SPidrmAN99/SpiderHex/README.md

<h1 align="center">SPIDER-HEX</h1>

<p align="center">
  <strong>A six-legged robot, built from gears, servos, and a lot of iteration.</strong><br>
  Mechanical design · ESP32 MicroPython · Bluetooth control
</p>

<p align="center">
  
  
  
  
</p>

<p align="center">
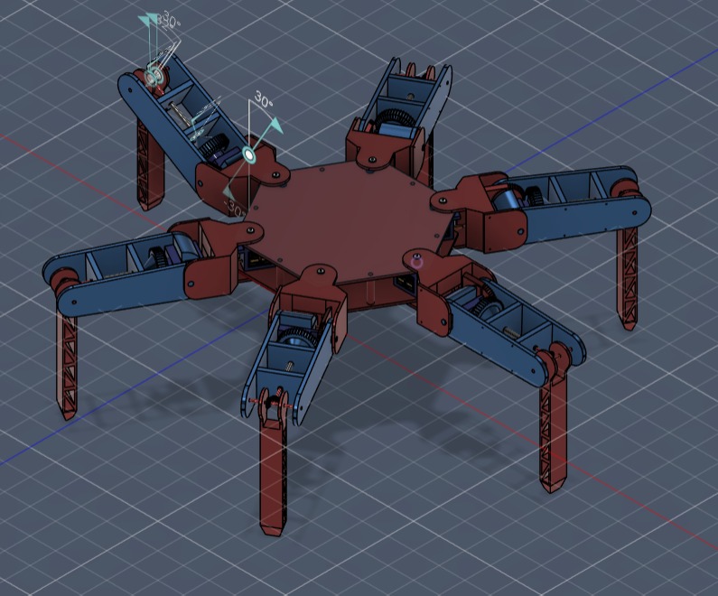
[picture p1: docs/images/final-design-cad.jpg]
CAD concept for the final Spider-Hex design, showing six geared legs around the central body
  
</p>

<p align="center">
  <strong>Final design direction — six geared legs around a compact central body.</strong><br><sub><a href="docs/images/final-design-fusion-screenshot.png">Open the original Fusion screenshot</a></sub>
</p>

---

## The project

Spider-Hex is a six-legged hexapod platform exploring custom geared leg mechanisms and wireless movement control. The repository brings together ESP32 firmware, BLE clients, control notes, CAD renders, build photos, and progress videos.

| At a glance |  |
|:--|:--|
| **Locomotion** | Six legs with hip and knee servo channels |
| **Controller** | ESP32 running MicroPython |
| **Wireless link** | Bluetooth Low Energy using a Nordic UART-style service |
| **Servo driver** | PCA9685 over I²C |
| **Development status** | Experimental prototype; hardware behavior depends on the current firmware iteration |

## Build videos

The short GIF previews loop right here in the README. Use **Full MP4** to open the original clip.

<table>
  <tr>
    <td width="50%" align="center">
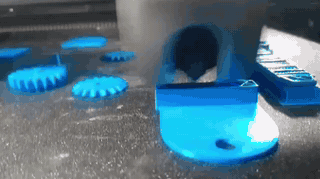
[picture p2: docs/videos/previews/printed-gear-components.gif]
Looping video preview: printed gear components
      <br>
      <strong>Printed gear components</strong><br><a href="docs/videos/printed-gear-components.mp4">▶ Full MP4 · 3 sec</a>
    </td>
    <td width="50%" align="center">
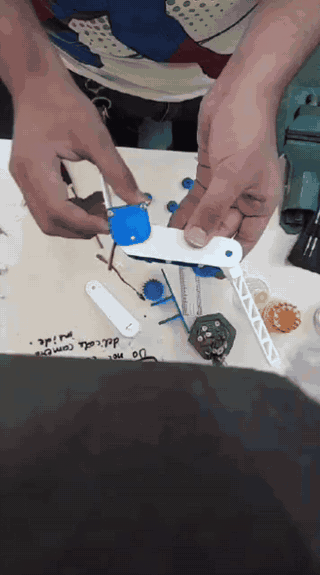
[picture p3: docs/videos/previews/linkage-assembly.gif]
Looping video preview: leg linkage assembly
      <br>
      <strong>Leg linkage assembly</strong><br><a href="docs/videos/linkage-assembly.mp4">▶ Full MP4 · 4 sec</a>
    </td>
  </tr>
  <tr>
    <td width="50%" align="center">
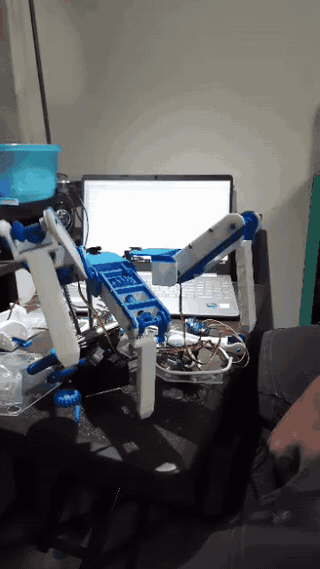
[picture p4: docs/videos/previews/workbench-prototype.gif]
Looping video preview: Spider-Hex prototype on the workbench
      <br>
      <strong>Prototype on the workbench</strong><br><a href="docs/videos/workbench-prototype.mp4">▶ Full MP4 · 4 sec</a>
    </td>
    <td width="50%" align="center">
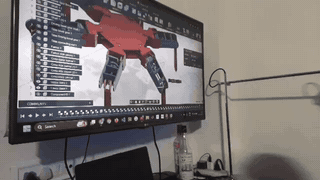
[picture p5: docs/videos/previews/cad-model-walkthrough.gif]
Looping video preview: CAD model walkthrough
      <br>
      <strong>CAD model walkthrough</strong><br><a href="docs/videos/cad-model-walkthrough.mp4">▶ Full MP4 · 4 sec</a>
    </td>
  </tr>
  <tr>
    <td width="50%" align="center">
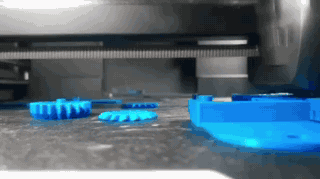
[picture p6: docs/videos/previews/printed-parts-closeup.gif]
Looping video preview: close-up of printed parts
      <br>
      <strong>Printed parts close-up</strong><br><a href="docs/videos/printed-parts-closeup.mp4">▶ Full MP4 · 3 sec</a>
    </td>
    <td width="50%" align="center">
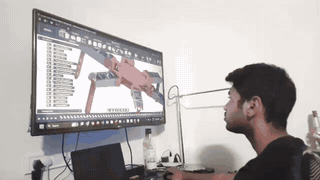
[picture p7: docs/videos/previews/cad-design-review.gif]
Looping video preview: CAD design review
      <br>
      <strong>CAD design review</strong><br><a href="docs/videos/cad-design-review.mp4">▶ Full MP4 · 4 sec</a>
    </td>
  </tr>
  <tr>
    <td width="50%" align="center">
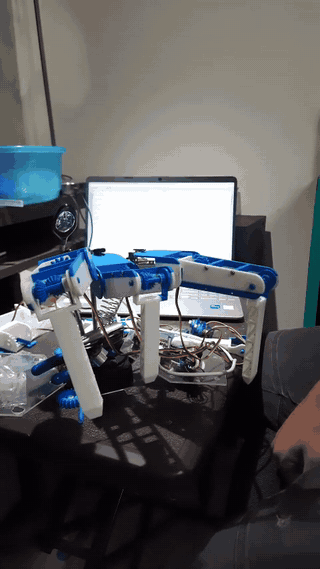
[picture p8: docs/videos/previews/hardware-prototype-session.gif]
Looping video preview: hardware prototype session
      <br>
      <strong>Hardware prototype session</strong><br><a href="docs/videos/hardware-prototype-session.mp4">▶ Full MP4 · 45 sec</a>
    </td>
    <td width="50%" align="center">
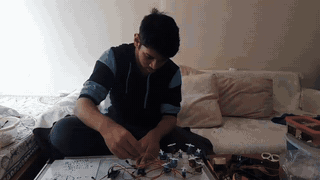
[picture p9: docs/videos/previews/electronics-assembly.gif]
Looping video preview: electronics assembly
      <br>
      <strong>Electronics assembly</strong><br><a href="docs/videos/electronics-assembly.mp4">▶ Full MP4 · 15 sec</a>
    </td>
  </tr>
</table>

## Design & build gallery

<table>
  <tr>
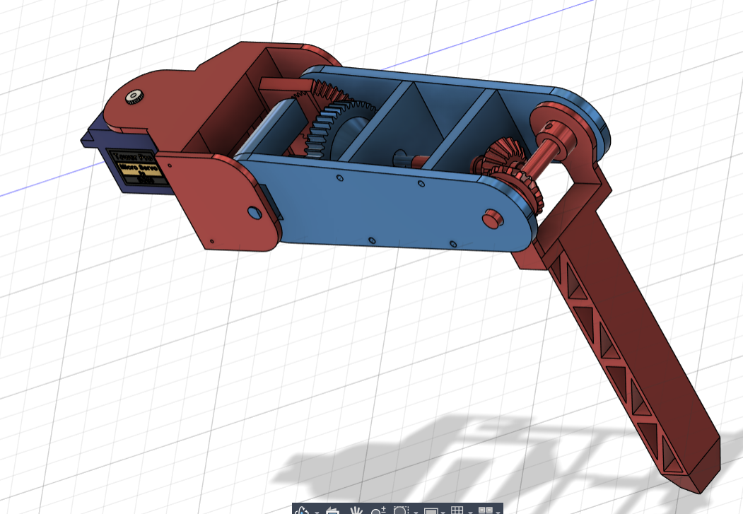
[picture p10: docs/images/leg-gearbox-cad-render.png]
CAD render of the leg gearbox and linkage
    <td width="50%" align="center"><br><strong>Geared leg mechanism</strong></td>
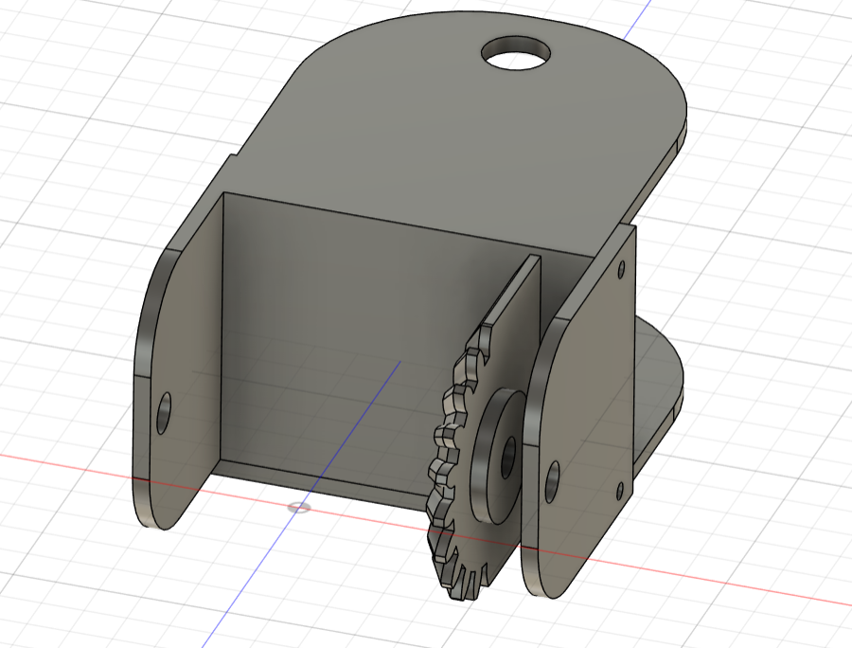
[picture p11: docs/images/leg-joint-cad-render.png]
CAD render of a leg joint and gear
    <td width="50%" align="center"><br><strong>Joint and gear layout</strong></td>
  </tr>
  <tr>
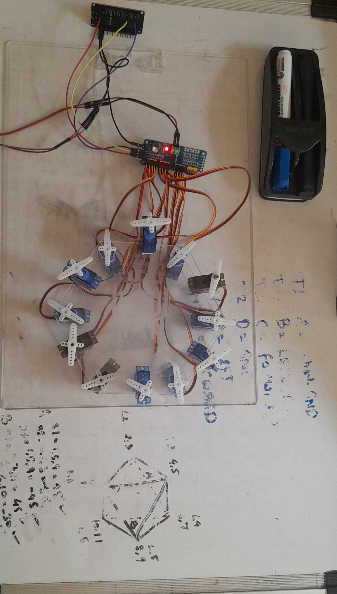
[picture p12: docs/images/assembled-spiderhex-prototype.png]
Spider-Hex electronics and servo assembly
    <td width="50%" align="center"><br><strong>Electronics and servo assembly</strong></td>
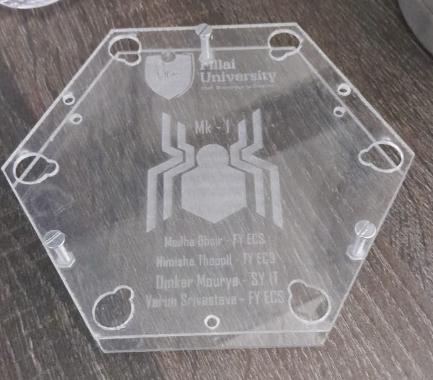
[picture p13: docs/images/team-engraved-top-plate.png]
Engraved Spider-Hex top plate
    <td width="50%" align="center"><br><strong>Custom engraved top plate</strong></td>
  </tr>
</table>

## Control interface

The screenshots show the Android BLE controller included in `Android/SpiderHexController/`.

<table>
  <tr>
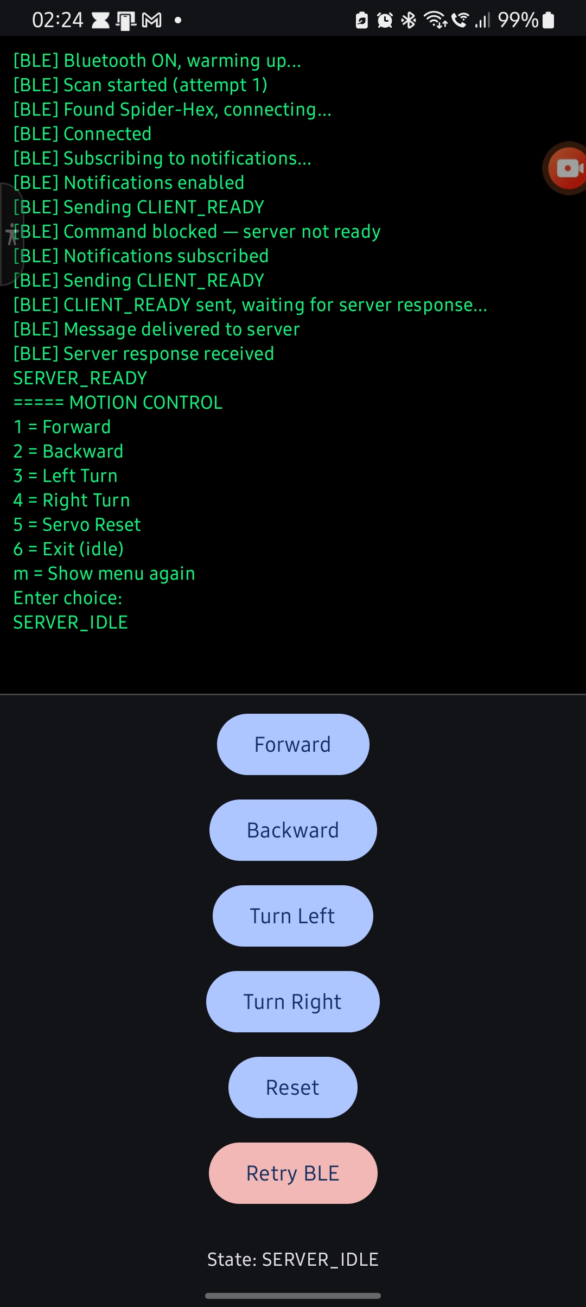
[picture p14: docs/images/mobile-controller-ble-connected.jpg]
Android controller connected to Spider-Hex over BLE
    <td align="center"><br><strong>Connected</strong></td>
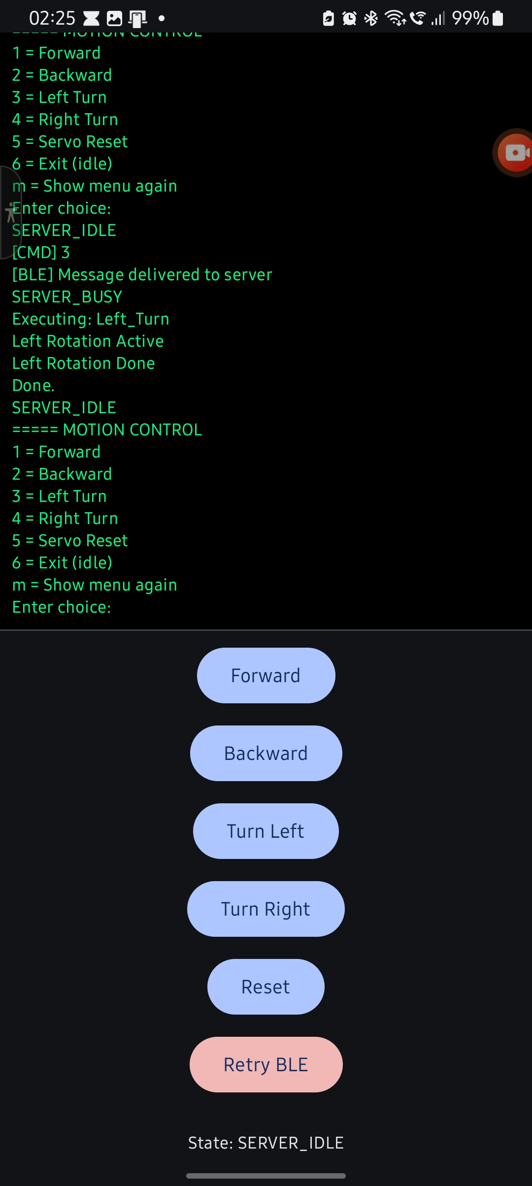
[picture p15: docs/images/mobile-controller-left-turn.jpg]
Android controller issuing a left-turn command
    <td align="center"><br><strong>Left turn</strong></td>
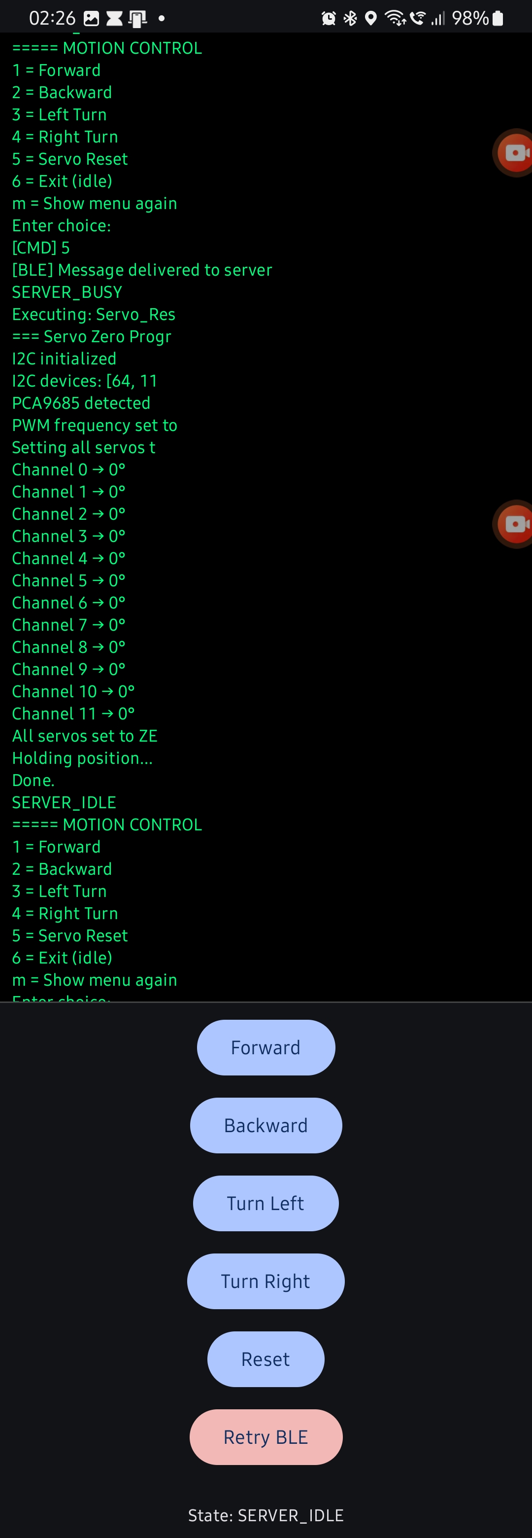
[picture p16: docs/images/mobile-controller-servo-reset.jpg]
Android controller issuing a servo reset
    <td align="center"><br><strong>Servo reset</strong></td>
  </tr>
</table>

## Firmware & control code

The repository preserves several firmware iterations. Modular **V5** is an experimental development reference; V4 and V6 snapshots are also included.

### Hardware assumptions in V5

| Component | V5 configuration |
|:--|:--|
| ESP32 | MicroPython |
| PCA9685 | I²C address `0x40`; SDA `21`, SCL `22` |
| Ultrasonic sensor | HC-SR04-style; TRIG `5`, ECHO `18` |
| BLE device name | `Spider-Hex` |
| Laptop client | Python with [`bleak`](https://github.com/hbldh/bleak) |

Pin assignments, servo angles, and wiring may need adjustment for the assembled robot.

### Run the laptop BLE client

Install `bleak`, then run:

```bash
python -m pip install bleak
python "BT/Laptop side/V5/ble_client_v5.py"
```

Copy the files under `BT/ESP32 side/V5/` to the ESP32 while preserving the `core/` and `motion/` folders, then start `main.py` with MicroPython.

### V5 command map

| Key | Command |
|:--:|:--|
| `1` | Forward |
| `2` | Backward |
| `3` | Turn left |
| `4` | Turn right |
| `5` | Reset servos |
| `6` | Stop *(not currently reliable)* |

> **Prototype limitation:** V5 runs its gait loop synchronously. While it is moving, it cannot process another BLE command or refresh the obstacle-distance reading. Treat V5 as a code reference only; do not rely on `STOP` or obstacle avoidance as safety controls.

## Android BLE controller

The native Android controller is a Kotlin and Jetpack Compose app. It scans for the `Spider-Hex` BLE device, connects to its UART-style service, sends movement commands, and displays server messages.

Open `Android/SpiderHexController/` in Android Studio and run the app on an Android device running API 31 or later. The repository includes the Gradle wrapper; machine-specific `local.properties` is intentionally omitted.

> **Firmware compatibility:** This app is from an earlier firmware iteration. It looks for a `SERVER_READY` response, while the experimental V5 firmware currently replies with `SERVER READY`. Align the protocol before pairing the Android app with V5.

## CAD and hardware references

`CAD/` now contains the Blender leg model, the editable Fusion 360 bevel model, DXF base drawings, and versioned STL print exports for V1–V3. See [`CAD/README.md`](CAD/README.md) for the file map. Circuit pinouts, battery and sensor references, the SG90 dimension sheet, and the original app-interface artwork are under `docs/`.

The project workbook is available as [`SpiderHex project plan v3`](docs/SpiderHex-project-plan-v3.xlsx).

## Additional firmware snapshots

Alongside the V5 prototype, `BT/ESP32 side/V4/` and `V6/` preserve older iteration files and an uploaded V4 snapshot. `BT/Diagnostics/` contains servo, motor, I²C, reset, and gait experiments. The two same-name source variants that differed from the existing repository files are preserved under `BT/Source snapshots/` rather than replacing the tracked versions.

## Repository map

| Path | Contents |
|:--|:--|
| `BT/ESP32 side/` | ESP32 BLE firmware, V4–V6 snapshots, and modular V5 prototype |
| `BT/Laptop side/` | Laptop BLE clients |
| `BT/Diagnostics/` | Motor, servo, sensor, and connectivity experiments |`n| `BT/Source snapshots/` | Alternate source-folder versions preserved for comparison |
| `Android/SpiderHexController/` | Kotlin/Compose Android BLE controller source |
| `CAD/` | Blender, Fusion 360, DXF, and V1–V3 STL files |
| `Control_Logic/` | Gait and control reference documents |
| `docs/images/` | Build photos, CAD renders, and controller screenshots |
| `docs/hardware/` | Wiring diagrams and component references |
| `docs/app-design/` | Earlier app-interface artwork |
| `docs/branding/` | Spider-Hex app logo source |
| `docs/SpiderHex-project-plan-v3.xlsx` | Project plan workbook |
| `docs/videos/` | Original MP4 clips and looping inline GIF previews |

---

<p align="center"><sub>Spider-Hex Mk I · A work in progress, one leg at a time.</sub></p>
