SPidrmAN99/SpiderHex/Control_Logic/Pitch logic.docx

5. PITCH LOGIC
Pitch FORWARD (nose down):
- Front legs → knee DOWN
- Rear legs → knee UP

Pitch BACKWARD (nose up):
- Front legs → knee UP
- Rear legs → knee DOWN

Middle legs remain neutral for stability.
