SPidrmAN99/SpiderHex/docs/hardware/18650 Battery and Holder.png

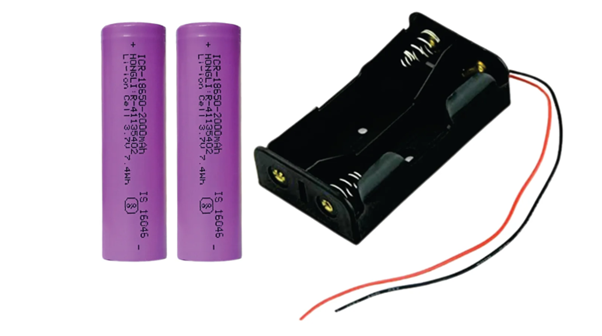
docs/hardware/18650 Battery and Holder.png
