SPidrmAN99/SpiderHex/docs/hardware/Battery Charging Module TP4056 Pinout.png

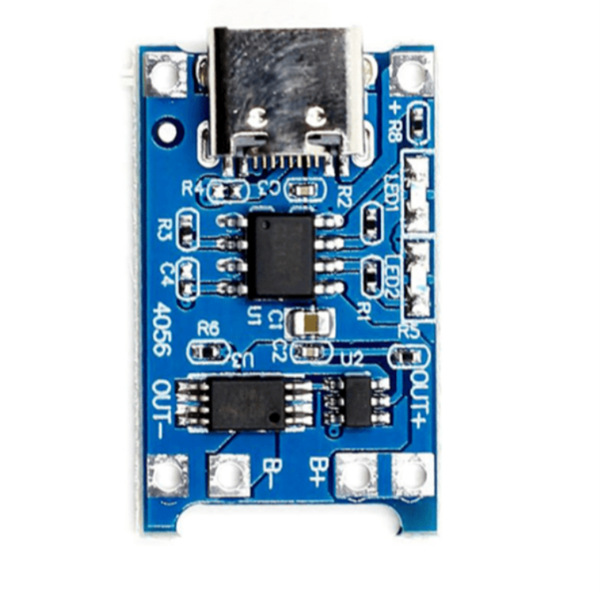
docs/hardware/Battery Charging Module TP4056 Pinout.png
