SPidrmAN99/SpiderHex/docs/hardware/Driver (PCA9685) Pinout.png

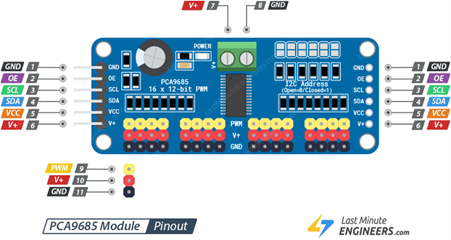
docs/hardware/Driver (PCA9685) Pinout.png
