SPidrmAN99/SpiderHex/docs/hardware/ESP32 Devkit V1 Pinout.png

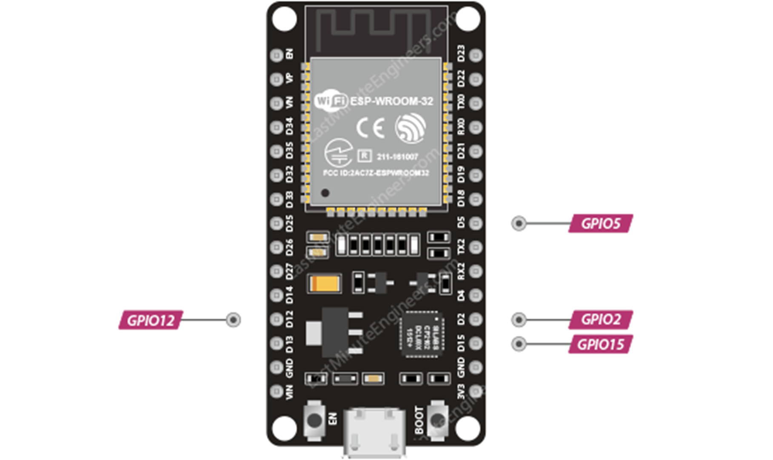
docs/hardware/ESP32 Devkit V1 Pinout.png
