SPidrmAN99/SpiderHex/docs/hardware/SG90-dimensions.jpg

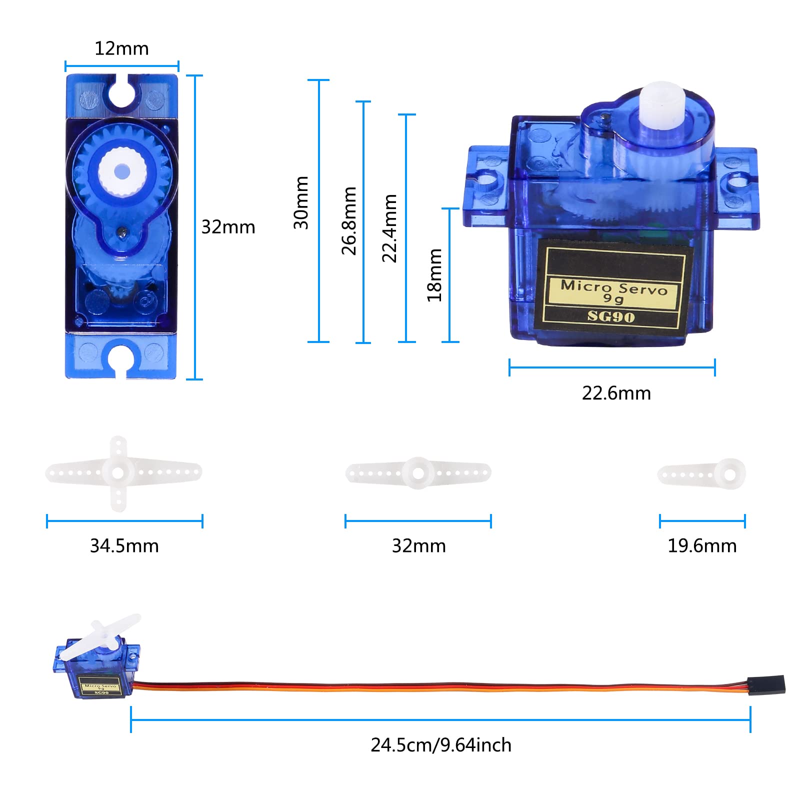
docs/hardware/SG90-dimensions.jpg
