SPidrmAN99/SpiderHex/docs/hardware/SONAR HC-SR04 Pinout.jpg

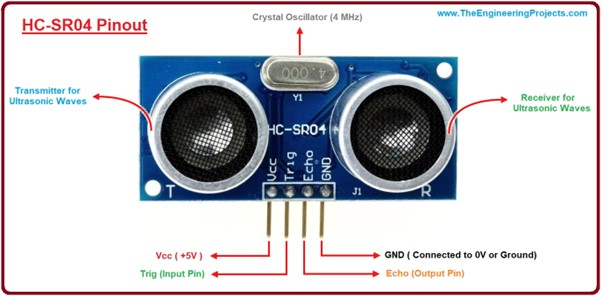
docs/hardware/SONAR HC-SR04 Pinout.jpg
