SPidrmAN99/SpiderHex/docs/images/final-design-fusion-screenshot.png

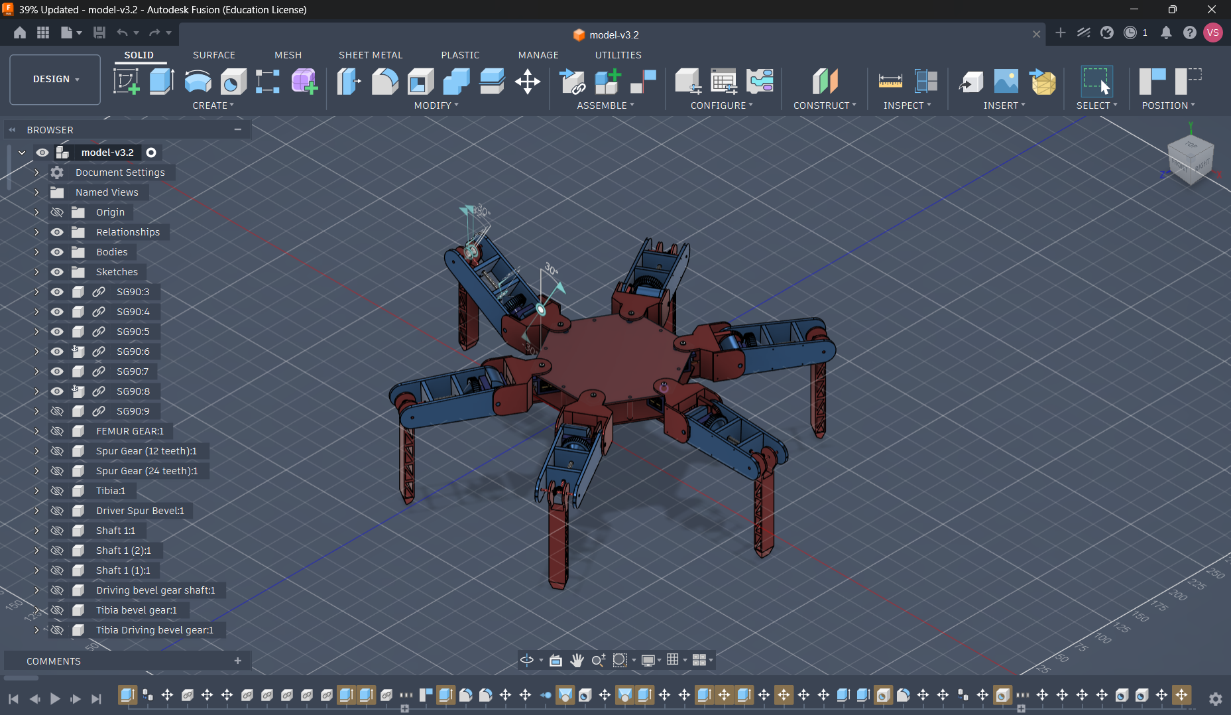
docs/images/final-design-fusion-screenshot.png
