SPidrmAN99/SpiderHex/docs/videos/thumbs/cad-design-review.jpg

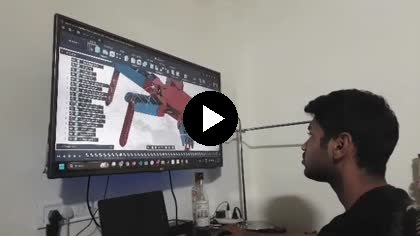
docs/videos/thumbs/cad-design-review.jpg
