SPidrmAN99/SpiderHex/docs/videos/thumbs/cad-model-walkthrough.jpg

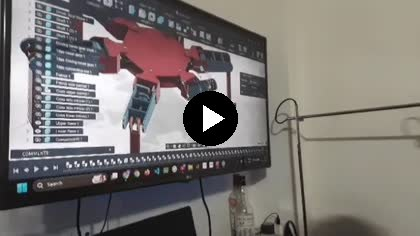
docs/videos/thumbs/cad-model-walkthrough.jpg
