SPidrmAN99/SpiderHex/docs/videos/thumbs/hardware-prototype-session.jpg

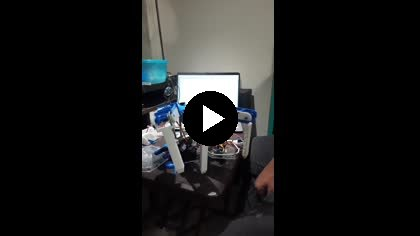
docs/videos/thumbs/hardware-prototype-session.jpg
