SPidrmAN99/SpiderHex/docs/SpiderHex-project-plan-v3.xlsx

Sheet: Sheet1
Component | Weight (g)
ESP32 | 10
PCA9685 | 10
HC-SR04 | 9
2s 18650 | 84
SG90 (x8) | 72
MG90s (x4) | 52
Body | 100
Bearing (x8) | 80
Misc | 35
Total | 452

Sheet: Project Timeline
Project: | Spider-Hex | Timeline: | 30 Days |  |  |  |  | Progress | 73.10526316%
Target: | 2025-12-31 | Final Submittion | 2026-01-05 |  |  |  |  | Pending | 27%
S.No | Task | Days | Start Date | Target Date | Completion Date | Complete % | Contributor | Dependency | Status | Remark
1 | Rough bot design (On Paper) | 1 | 2025-12-04 | 2025-12-04 | 2025-12-04 | 100% | Varun |  | Completed
2 | Draft PPT | 1 | 2025-12-06 | 2025-12-06 | 2025-12-06 | 100% | Medha, Nimisha, Omkar, Varun |  | Completed
3 | Bot design (Blender) | 1 | 2025-12-08 | 2025-12-09 |  | 100% | Varun |  | On Hold
4 | Bot design (Fusion 360) | 2 | 2025-12-09 | 2025-12-10 | 2025-12-18 | 99% | Varun+ |  | In Review | 26-Dec: Gear re-design pending 18-Dec: Final assembly remaining 16-Dec: CAD model failed 13-Dec: Behind Target 12-Dec: Behind Target 11-Dec: Behind Target 10- Dec: Behind target
5 | Components list | 1 | 2025-12-05 | 2025-12-05 | 2025-12-09 | 100% | Varun |  | Completed
6 | Components Available | 0 | 2025-12-05 | 2025-12-05 | 2025-12-05 | 100% | Lab |  | Completed | 10% Available
7 | Logic build for ESP operation | 0.5 | 2025-12-09 | 2025-12-09 | 2025-12-10 | 100% | Nimisha, Medha |  | Completed | 12-Dec: Logic reviewed 10-Dec: Logic under review 09-Dec: Behind Target
8 | Components Not-Available | 1 | 2025-12-10 | 2025-12-12 |  | 100% | Omkar | 9, 10 | Completed | 90% Purchase
9 | 3D Printing One Leg + Base | 1 | 2025-12-11 | 2025-12-11 | 2025-12-25 | 90% | Medha, Nimisha, Omkar, Varun & Sir | 4 | In Review | 25-Dec: Resolving Trial and errors 18-Dec: Identified Trial and errors 18-Dec: 3D printing for one Leg done
10 | BOT Basic Physical design (One Leg) | 1 | 2025-12-12 | 2025-12-12 |  | 80% | Medha, Nimisha, Omkar, Varun | 9 | In Review | 25-Dec: 3D Printing (Gear re-print for testing) 23-Dec: Gear needs to re-design
11 | 3D Printing Remaining Objects | 1 | 2025-12-13 | 2025-12-13 |  | 10% | Medha, Nimisha, Omkar, Varun & Sir | 10 | Blocked / Dependency | 25-Dec: Gear re-design in progress as 2nd 3D Printing not appropriate
12 | Mobile App Design - Draft | 1 | 2025-12-07 | 2025-12-10 | 2025-12-10 | 100% | Omkar |  | Completed
13 | Mobile App Build | 2 | 2025-12-11 | 2025-12-15 |  | 100% | Omkar, Varun | 12 | Completed | 26-Dec: Varun created new Mobile App (Working fine all functions) 25-Dec: App not functioning, Varun started building new App
14 | Model basic testing | 1 | 2025-12-15 | 2025-12-15 |  | 40% | Medha, Nimisha, Omkar, Varun |  | In Progress | 25-Dec: Base ready, 3D printing and App build in progress
15 | BOT physical final build | 3 | 2025-12-16 | 2025-12-18 |  | 20% | Medha, Nimisha, Omkar, Varun |  | In Progress | 25-Dec: (a) Body base structure done. (b) Gear re-design and 3D Printing in progress
16 | BOT ESP integration | 1 | 2025-12-19 | 2025-12-19 |  | 100% | Medha, Nimisha, Omkar, Varun |  | Completed | 26-Dec: New Mobile App created by Varun, connectivity established between Mobile and ESP32. All functions working as expected (Forward, Back, Turn Left, Turn Right, Reset) 25-Dec: Connectivity and ESP logics fine over Laptop BT. Mobile App integration not working. 25-Dec: Back, Turn Left, Turn Right logic created by Nimisha. Logic working as expected and uploaded in ESP32.
17 | BOT Testing | 1 | 2025-12-20 | 2025-12-20 |  | 20% | Medha, Nimisha, Omkar, Varun |  | In Progress | 25-Dec: 3D Printing, App Integration Pending.
18 | Final Documentation/ PPT | 3 | 2025-12-21 | 2025-12-23 |  | 30% | Medha, Nimisha, Omkar, Varun |  | In Progress | 25-Dec: (a) Project Current Status (b) Estimated vs Actual Cost (c) Purchase vs Existing (d) SpiderHex - Task Status (e) Components List
19 | BOT Final Demo | 0.5 | 2025-12-26 | 2025-12-26 |  | 0% | Medha, Nimisha, Omkar, Varun |  | Not Started
 | Total | 23 |  |  |  | 73.10526316%

Sheet: LegMovement Logic
GAIT-CYCLE | Back | Rotation | Forward | Rotation2 | TURN-LOGIC | Right | Rotation3 | Left | Rotation4 | Pitch | Down | Rotation5 | Up | Rotation6
Step-1 | 1.2, 3.2 |  | 1.2, 3.2 |  | Step-1 | 1.2, 3.2 |  | 1.2, 3.2 |  | Step-1 | 1.2 |  | 1.2
 | 5.2 |  | 5.2 |  |  | 5.2 |  | 5.2 |  |  | 3.2 |  | 3.2
Step-2 | 1.1,3.1 |  | 1.1,3.1 |  | Step-2 | 1.1,3.1,5.1 |  | 1.1,3.1,5.1 |  |  | 4.2 |  | 4.2
 | 5.1 |  | 5.1 |  |  |  |  |  |  |  | 6.2 |  | 6.2
Step-3 | 1.2,3.2 |  | 1.2,3.2 |  | Step-3 | 1.2,3.2 |  | 1.2,3.2
 | 5.2 |  | 5.2 |  |  | 5.2 |  | 5.2
Step-4 | 2.2 |  | 2.2 |  | Step-4 | 2.2 |  | 2.2
 | 4.2,6.2 |  | 4.2,6.2 |  |  | 4.2,6.2 |  | 4.2,6.2
Step-5 | 2.1 |  | 2.1 |  | Step-5 | 2.1,4.1,6.1 |  | 2.1,4.1,6.1
 | 4.1,6.1 |  | 4.1,6.1
Step-6 | 2.2 |  | 2.2 |  | Step-6 | 2.2 |  | 2.2
 | 4.2,6.2 |  | 4.2,6.2 |  |  | 4.2,6.2 |  | 4.2,6.2
Step-7 | 1.1,2.1,3.1 |  | 1.1,2.1,3.1 |  | Step-7 | 1.1,2.1,3.1 |  | 1.1,2.1,3.1
 | 4.1,5.1,6.1 |  | 4.1,5.1,6.1 |  |  | 4.1,5.1,6.1 |  | 4.1,5.1,6.1

Sheet: ComponentCost-Estimated-Actual
Used Components |  |  |  | Estimated Cost |  |  | Purchased Cost |  | College Provided Cost |  | Actual Cost
S.No | Item | Available | Qty | Unit Cost (Approx) | Max Unit Cost | Estimated Cost | Unit cost (Purchased) | Purchased | Unit Cost | College provided | Actual Cost (with 18% GST)
1 | Li-ion Battery (3.7v 2600mAh) - 18650 | No | 2 | 200 | 200 | ₹400.00 | 200 | ₹400.00 | 0 | ₹0.00 | ₹400.00
2 | PCA9685 PWM/Servo Driver | No | 1 | 200-250 | 250 | ₹250.00 | 325 | ₹325.00 | 0 | ₹0.00 | ₹325.00
3 | Servos SG90 | No | 6 | 130-150 | 150 | ₹900.00 | 90 | ₹540.00 | 0 | ₹0.00 | ₹540.00
4 | Battery capacity indicator module -3s18650 | No | 1 | 80-100 | 100 | ₹100.00 | 90 | ₹90.00 | 0 | ₹0.00 | ₹90.00
5 | Battery charging module - TP4056 - C Type USB Prote | No | 1 | 10-20 | 20 | ₹20.00 | 20 | ₹20.00 | 0 | ₹0.00 | ₹20.00
6 | Battery Holder | No | 1 | 20-30 | 30 | ₹30.00 | 25 | ₹25.00 | 0 | ₹0.00 | ₹25.00
7 | Acrylic Sheet | No | 1 | 150-200 | 177.5 | ₹177.50 | 177 | ₹177.00 | 0 | ₹0.00 | ₹177.00
8 | Servos SG90 | Yes | 6 | 130-150 | 150 | ₹900.00 | 0 | ₹0.00 | 90 | ₹540.00 | ₹540.00
9 | Buck Converter | Yes | 1 | 39-100 | 100 | ₹100.00 | 0 | ₹0.00 | 80 | ₹80.00 | ₹80.00
10 | Creality Hyper PLA RFID 3D Printer Filament (0.5kg /1kg) | Yes | 1 | 1000-1139 | 1139 | ₹1139.00 | 0 | ₹0.00 | 1139 | ₹1139.00 | ₹1139.00
11 | On-Off Switch | Yes | 1 | 20-30 | 30 | ₹30.00 | 0 | ₹0.00 | 30 | ₹30.00 | ₹30.00
12 | Wires (Male / Female connectors) | Yes | 2 | 150-200 | 200 | ₹400.00 | 0 | ₹0.00 | 100 | ₹200.00 | ₹200.00
13 | Battery Holder | Yes | 2 | 15-20 | 20 | ₹40.00 | 18 | ₹36.00 | 0 | ₹0.00 | ₹0.00
14 | Misc (Sholdering Wire, Paste, Wick etc) | Yes | 1 | 200-300 | 300 | ₹300.00 | 0 | ₹0.00 | 100 | ₹100.00 | ₹100.00
 | Total |  |  |  |  | ₹4786.50 |  | ₹1613.00 |  | ₹2089.00 | ₹3666.00
Future Enhansment Plan (Additional Components) |  |  | Estimated Cost |  |  |  | Actual Cost |  |  | College provided | Actual Cost
S.No | Item | Available | Qty | Unit Cost (Approx) | Max Unit Cost | Estimated Total Cost | Visha World cost | Visha World Total Cost | Unit Cost (College provided ) | College provided Components | General Cost
1 | GY-273 QMC5883L 3-Axis Magnetic Field Sensor | No | 1 | 100-150 | 150 | ₹150.00 | 400 |  |  |  | ₹0.00
1 | MPU6050 | No | 1 | 150-200 | 200 | ₹200.00 | 195 | ₹195.00 |  |  | ₹195.00
2 | OV7670 Cam |  | 1 | 150-200 | 200 | ₹200.00 | 150 |  |  |  | ₹0.00
3 | I2S Microphone Module | No | 1 | 400-450 | 450 | ₹450.00 | 240 | ₹240.00 |  |  | ₹240.00
4 | ESP32-CAM Development Board with OV2640 Camera Module | No | 1 | 800-900 | 900 | ₹900.00 | 650 |  |  |  | ₹0.00
5 | Servos MG90 | No | 1 | 100-200 | 200 | ₹200.00 | 195 | ₹195.00 |  |  | ₹195.00
6 | Lora Ra-02 433MHz Module + Antenna | No | 1 | 500-800 | 800 | ₹800.00 | 450 |  |  |  | ₹0.00
7 | PIR Motion Sensor Detector Module HC-SR501 | No | 1 | 30-55 | 55 | ₹55.00 | 55 | ₹55.00 |  |  | ₹55.00
8 | Creality Hyper PLA RFID 3D Printer Filament (0.5kg /1kg) | No | 1 | 1000-1139 | 1139 | ₹1139.00 | 1139 | ₹1139.00 |  |  | ₹1139.00
 | Total |  |  |  |  | ₹4094.00 |  | ₹1824.00 |  | ₹0.00 | ₹1824.00

Sheet: Final Components List
18650 Li-po Lithium Battery Capacity Indicator Module | 80 | 1 | 80
2 x 3.7V 18650 Battery Holder - 1 Pc | 23 | 1 | 23
TP4056 1A Li-ion lithium Battery Charging Module – Type C | 20 | 1 | 20
18650 2600mAh Lithium-Ion Battery - 1 Pc | 200 | 2 | 400
SG90 Micro Servo Motor | 90 | 6 | 540
PCA9685 - 16 Channel 12-Bit PWM Servo Motor Driver I2C Module | 350 | 1 | 350
 |  |  | 1413

Sheet: Trials & Errors
Sr. No. | Error Remark | Status | Remark
1 | Thickening of all Shafts to 5mm diameter | Done
2 | Thickening of connecting shaft to 10mm outer and 5.5mm inner diameter & screw holes for tightening | Done
3 | Locking Mechanism of Tibia Rod on one side only & locking cap on the other side | Pending
4 | Largening of Tibia Gears to 20mm dia & reducing number of teeth and screw holes for tightening | Partial | Reduce diameter
5 | Broadening of knee | Done
6 | Largening of all screw holes to 2mm dia and 6.5mm depth | Done
7 | Largening of all hole diameter by 0.75 to the shaft diameter (total holes: 7) | Done
8 | Coxa motor gear cork hole increase by .5 mm diameter & screw hole | Partial
9 | Motor Gear Crater to fix Femur motor | Partial | Printing failded, need to re-print
10 | Shortening of outer femur wall | Done | 3D Printing pending
11 | Reducing number of teeth on motor & coxa gear keeping the radius constant | Done | 3D printing error
12 | On AC -> DC 5v adapter working fine, howerver on battery, motors are drawing more voltage, due to that battery is draining fast.

Sheet: Sheet3
Status | Hex
Not Started | #BFBFBF
On Hold | #F4A460
Postponed | #FFC107
In Progress | #2196F3
In Review | #9C27B0
In Testing | #009688
Blocked / Dependency | #FF0000
Completed | #4CAF50
Failed | #8B0000
