SPidrmAN99/SpiderHex/docs/videos/thumbs/printed-parts-closeup.jpg

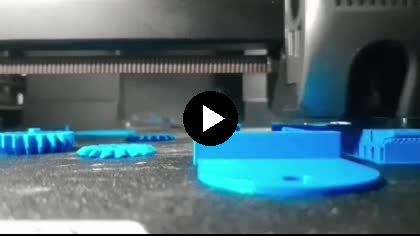
docs/videos/thumbs/printed-parts-closeup.jpg
