SPidrmAN99/SpiderHex/CAD/3D Print V3/Coxa Main.stl

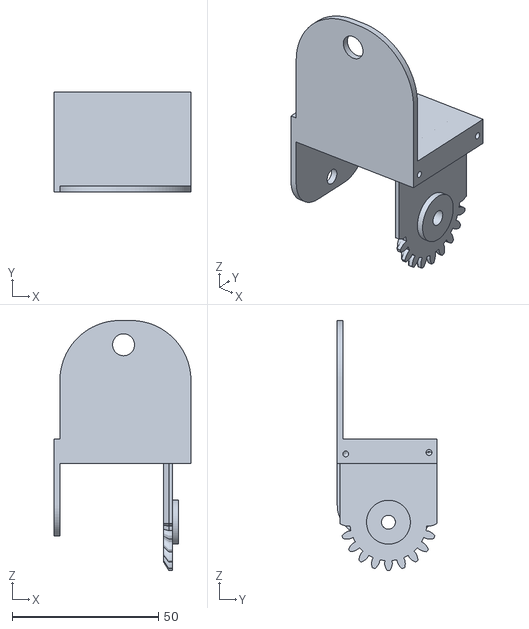
[picture p29: CAD file, 2026-10-29]
CAD/3D Print V3/Coxa Main.stl
46.8 x 34.0 x 85.4
