SPidrmAN99/SpiderHex/CAD/3D Print V3/Femur.stl

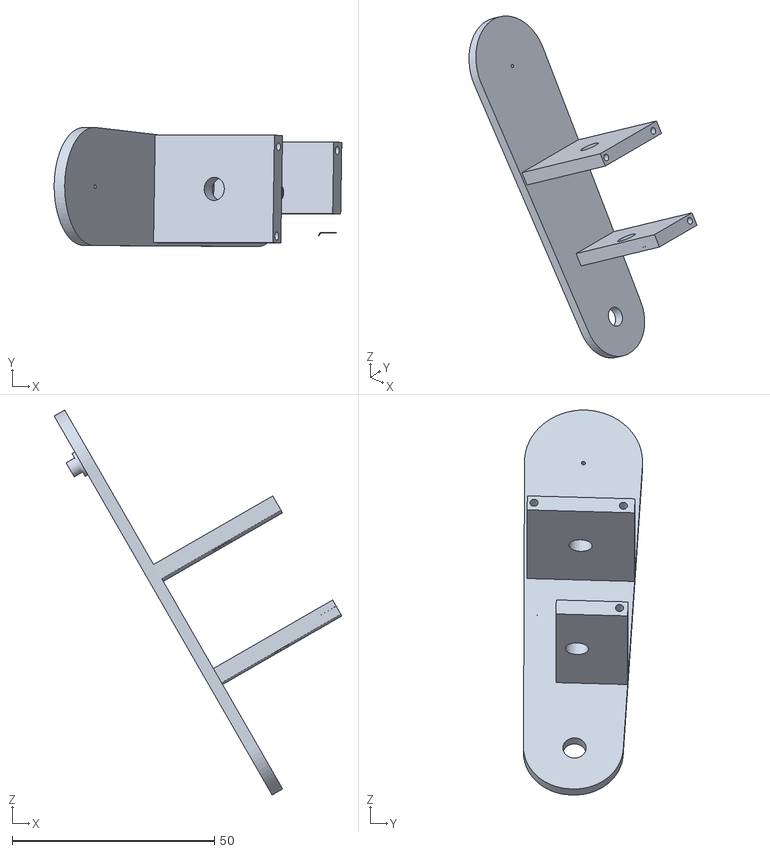
[picture p30: CAD file, 2026-10-29]
CAD/3D Print V3/Femur.stl
71.0 x 29.4 x 95.1
