SPidrmAN99/SpiderHex/CAD/Blender/Base.stl

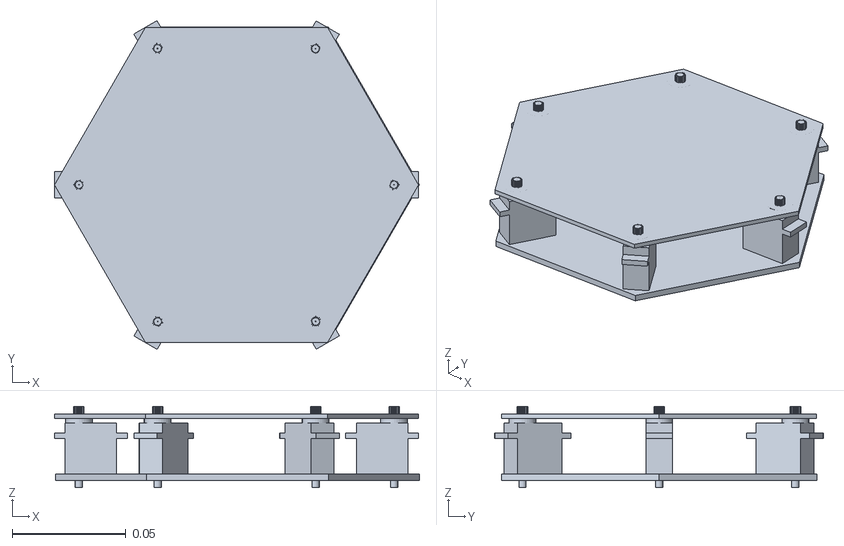
[picture p31: CAD file, 2026-10-29]
CAD/Blender/Base.stl
0.16 x 0.145 x 0.0356
