SPidrmAN99/SpiderHex/CAD/3D Print V3/Coxa Side Pannel.stl

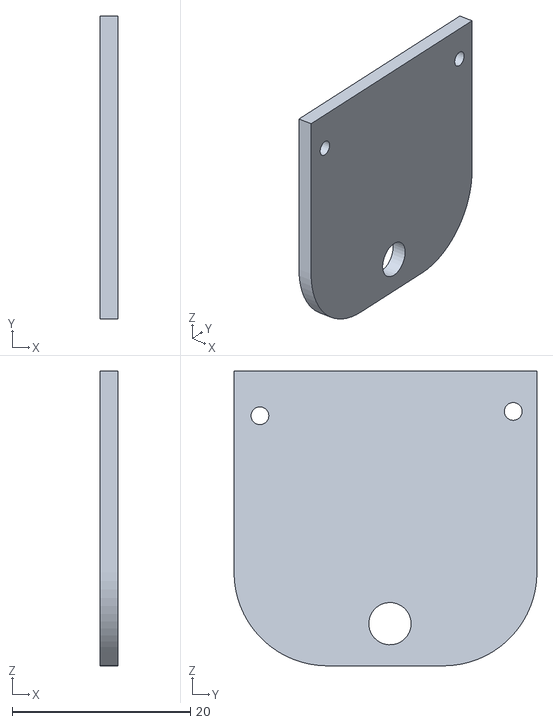
[picture p32: CAD file, 2026-10-29]
CAD/3D Print V3/Coxa Side Pannel.stl
2.00 x 34.0 x 33.1
