SPidrmAN99/SpiderHex/CAD/Blender/Leg.stl

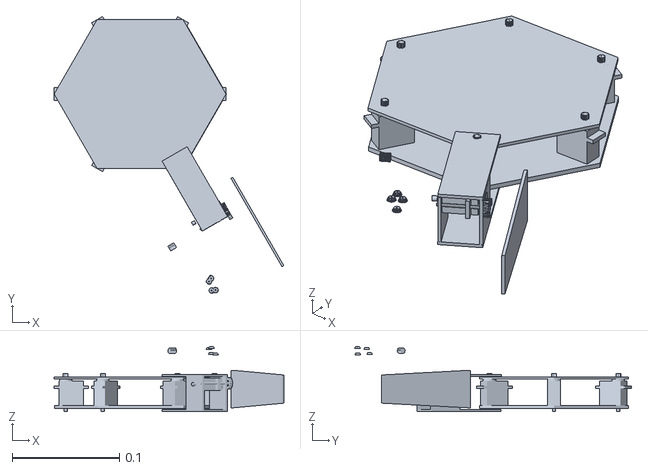
[picture p33: CAD file, 2026-10-29]
CAD/Blender/Leg.stl
0.214 x 0.258 x 0.061
