SPidrmAN99/SpiderHex/CAD/3D Print V3/Bevel Shaft.stl

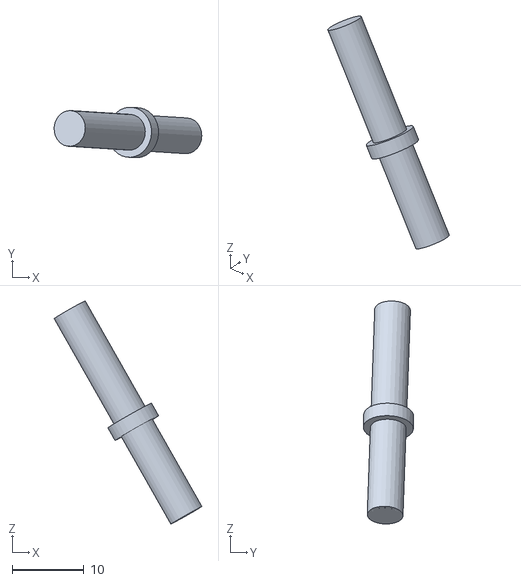
[picture p34: CAD file, 2026-10-29]
CAD/3D Print V3/Bevel Shaft.stl
20.6 x 7.04 x 31.1
