SPidrmAN99/SpiderHex/CAD/Blender/leg2.stl

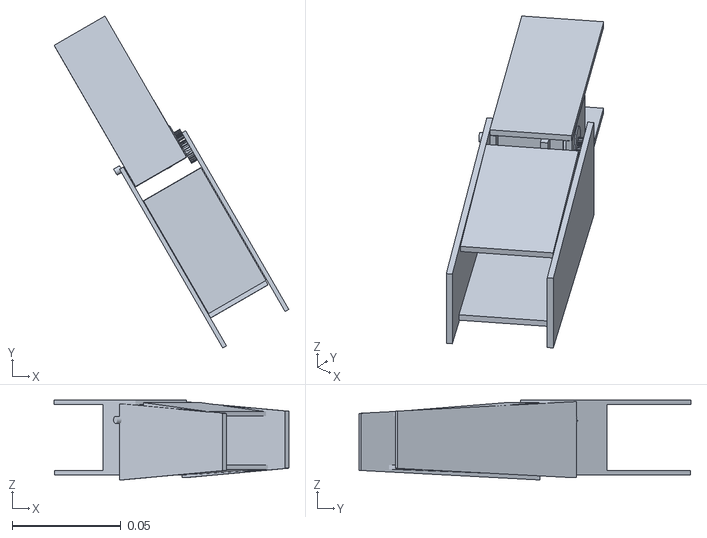
[picture p35: CAD file, 2026-10-29]
CAD/Blender/leg2.stl
0.108 x 0.153 x 0.0367
