SPidrmAN99/SpiderHex/CAD/3D Print V3/Coxa Rod.stl

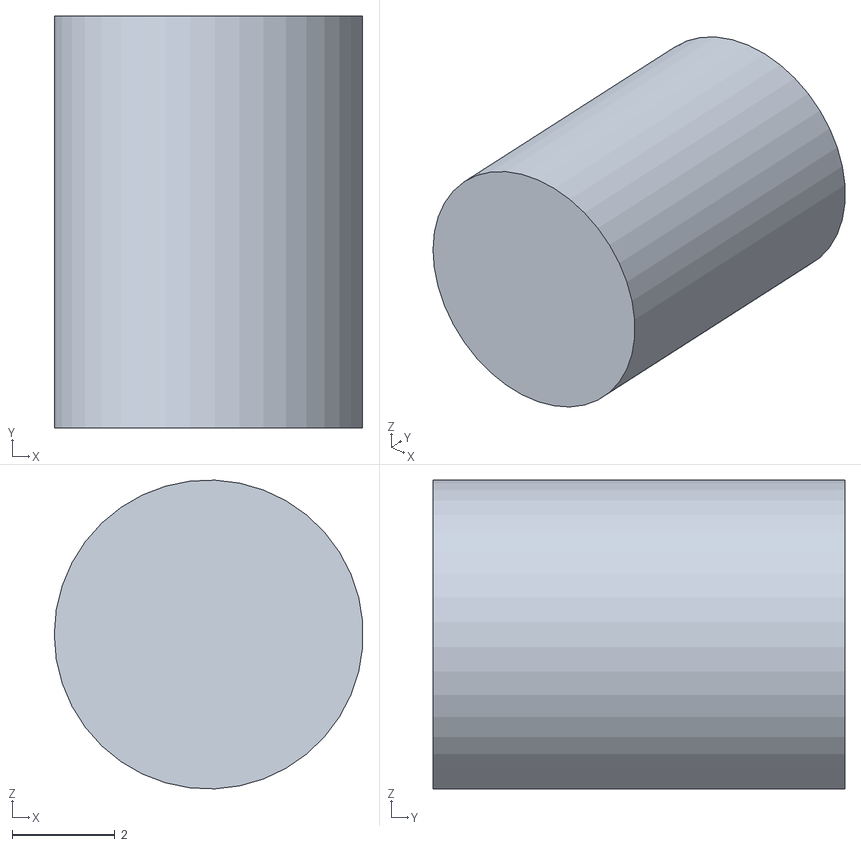
[picture p36: CAD file, 2026-10-29]
CAD/3D Print V3/Coxa Rod.stl
5.99 x 8.00 x 6.00
