SPidrmAN99/SpiderHex/CAD/3D Print V3/Tibia Connecting Rod.stl

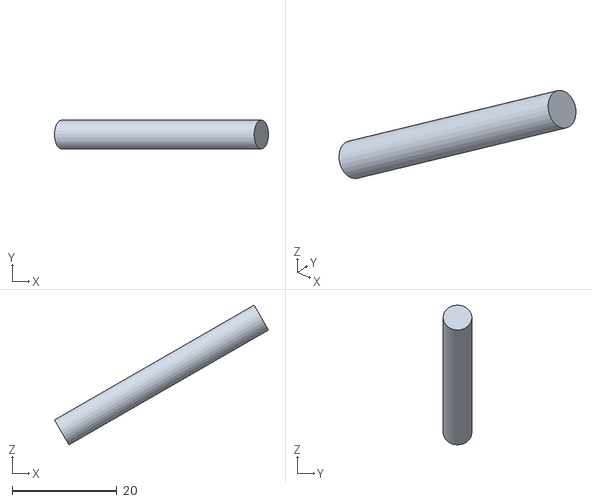
[picture p37: CAD file, 2026-10-29]
CAD/3D Print V3/Tibia Connecting Rod.stl
40.9 x 5.48 x 26.7
