SPidrmAN99/SpiderHex/CAD/3D Print V3/Tibia.stl

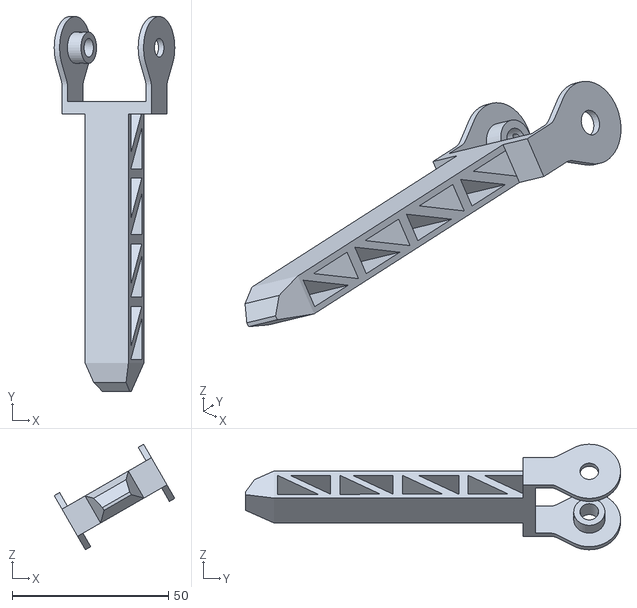
[picture p38: CAD file, 2026-10-29]
CAD/3D Print V3/Tibia.stl
38.6 x 120.0 x 33.8
