SPidrmAN99/SpiderHex/CAD/3D Print V3/Motor Gear.stl

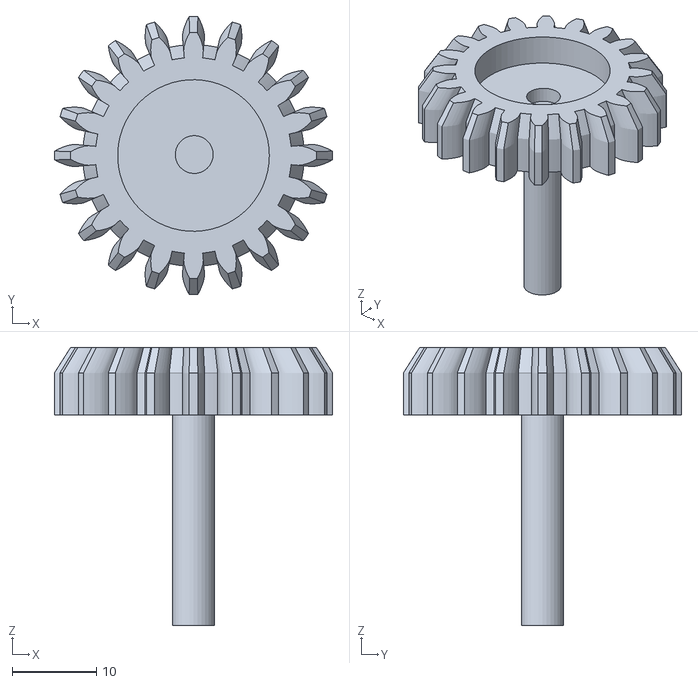
[picture p39: CAD file, 2026-10-29]
CAD/3D Print V3/Motor Gear.stl
33.0 x 33.0 x 33.0
