SPidrmAN99/SpiderHex/CAD/3D Print V3/Coxa Lower Pannel.stl

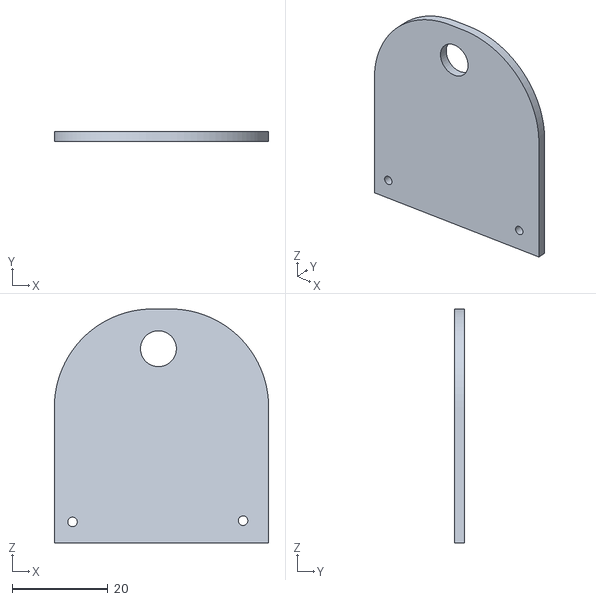
[picture p40: CAD file, 2026-10-29]
CAD/3D Print V3/Coxa Lower Pannel.stl
44.8 x 2.00 x 48.9
