SPidrmAN99/SpiderHex/CAD/3D Print V3/Tibia Bevel.stl

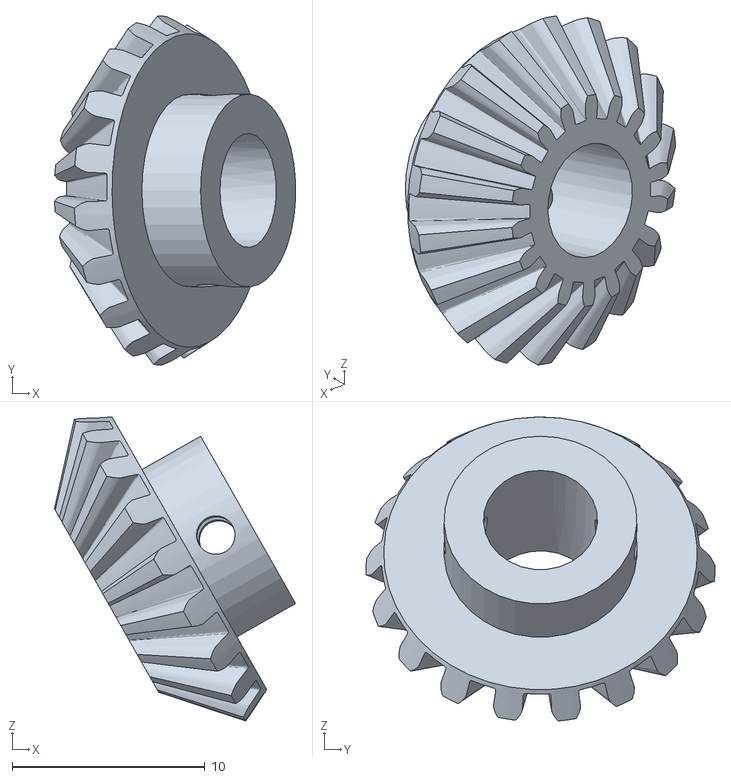
[picture p41: CAD file, 2026-10-29]
CAD/3D Print V3/Tibia Bevel.stl
12.5 x 18.1 x 15.8
