SPidrmAN99/SpiderHex/CAD/3D Print V1/Coxa main.stl

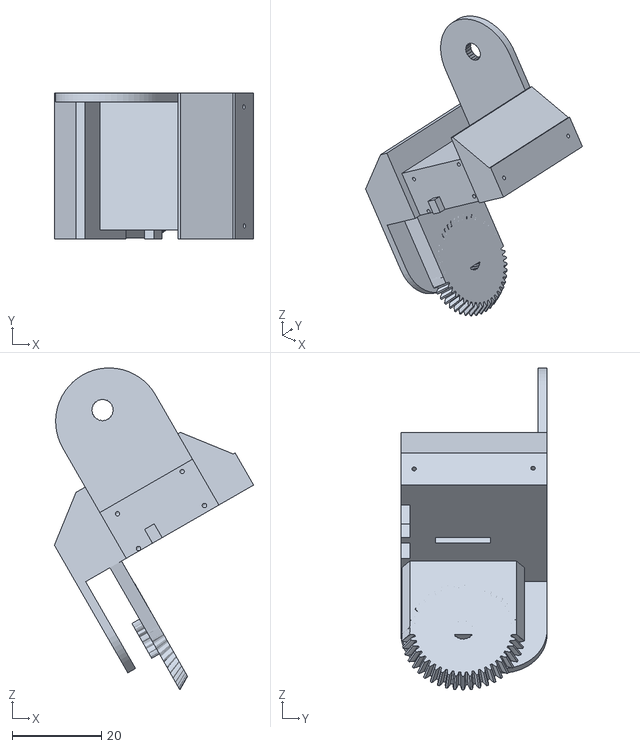
[picture p42: CAD file, 2026-10-29, an earlier design]
CAD/3D Print V1/Coxa main.stl
44.7 x 32.8 x 72.3
