SPidrmAN99/SpiderHex/CAD/3D Print V1/Tibia Connecting Rod.stl

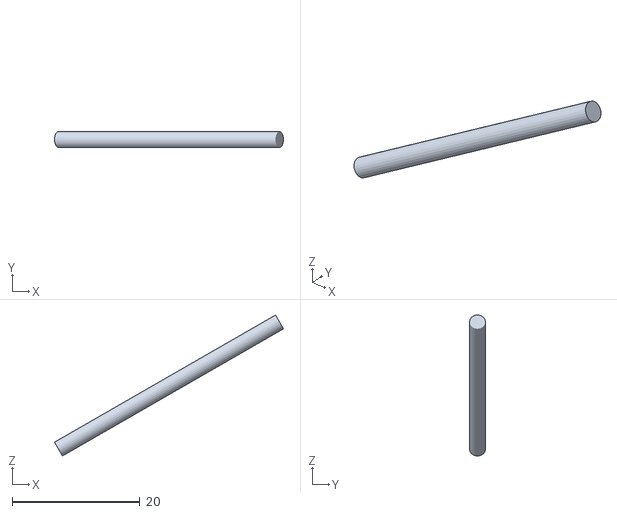
[picture p43: CAD file, 2026-10-29, an earlier design]
CAD/3D Print V1/Tibia Connecting Rod.stl
35.9 x 2.50 x 22.1
