SPidrmAN99/SpiderHex/CAD/3D Print V1/Femur.stl

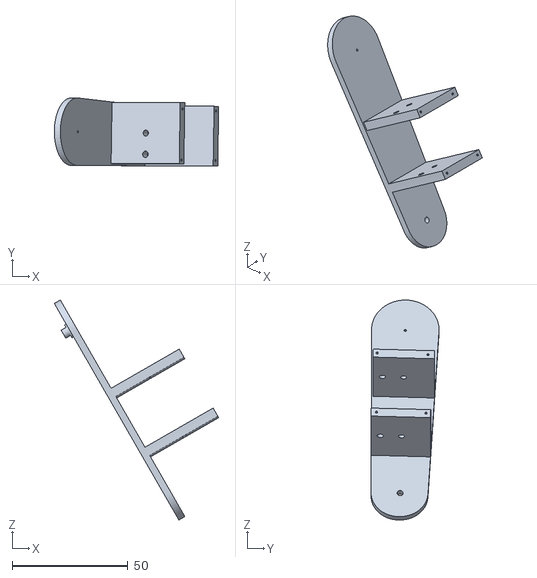
[picture p44: CAD file, 2026-10-29, an earlier design]
CAD/3D Print V1/Femur.stl
71.0 x 29.4 x 95.1
