SPidrmAN99/SpiderHex/(list of files, cad)

Other CAD files:
CAD/3D Print V2/Coxa Lower Pannel.stl
CAD/3D Print V2/Tibia.stl
CAD/3D Print V1/Bevel Shaft.stl
CAD/3D Print V1/Connecting Shaft.stl
CAD/3D Print V1/Coxa Lower Pannel.stl
CAD/3D Print V1/Coxa Side Pannel.stl
CAD/3D Print V1/Driving Bevel.stl
CAD/3D Print V1/Femur Side Pannel.stl
CAD/3D Print V1/Motor Gear.stl
CAD/3D Print V1/Tibia Bevel.stl
CAD/3D Print V1/Tibia.stl
CAD/3D Print V2/Base Drawing Sheet1.dxf
CAD/3D Print V2/Base.dxf
CAD/3D Print V2/Bevel Rod1.stl
CAD/3D Print V2/Bevel.f3d
CAD/3D Print V2/Connecting Shaft.stl
CAD/3D Print V2/Coxa Side Pannel.stl
CAD/3D Print V2/Coxa Upper Pannel.stl
CAD/3D Print V2/Femur Side Pannel.stl
CAD/3D Print V2/Femur.stl
CAD/3D Print V2/Tibia Bevel.stl
CAD/3D Print V2/Tibia Connecting Rod.stl
CAD/Blender/Leg.blend
