SPidrmAN99/SpiderHex/docs/videos/thumbs/electronics-assembly.jpg

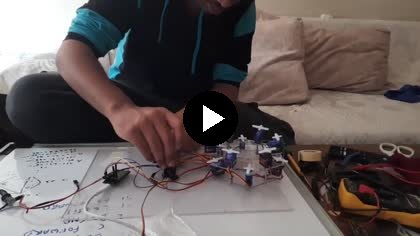
docs/videos/thumbs/electronics-assembly.jpg
