SPidrmAN99/SpiderHex/docs/videos/thumbs/linkage-assembly.jpg

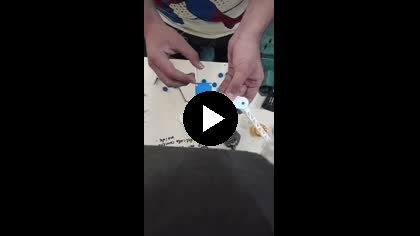
docs/videos/thumbs/linkage-assembly.jpg
