SPidrmAN99/SpiderHex/docs/videos/thumbs/printed-gear-components.jpg

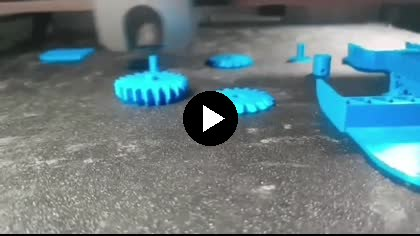
docs/videos/thumbs/printed-gear-components.jpg
