SPidrmAN99/SpiderHex/(commit log)

2025-12-14 Add servo and gait control pseudocode
2025-12-23 Pushed BLE Server and Client files
    BLE Server Files: Advertise-Pair, Menu, Main, Forward, Reverse, Servo Reset
    BLE Client Files: ble-client
    [Advertise_Pair_V4.py, Forward.py, Menu_V4.py, Servo_Reset.py, main.py, main_V4.py]
2026-10-29 Add experimental modular V5 BLE prototype
2026-10-29 Feature final CAD design in README
2026-10-29 Add Android controller, CAD and firmware archive
